dhaillant/REC/hardware/0.1/2024-04-18 14.53.38 det.jpg

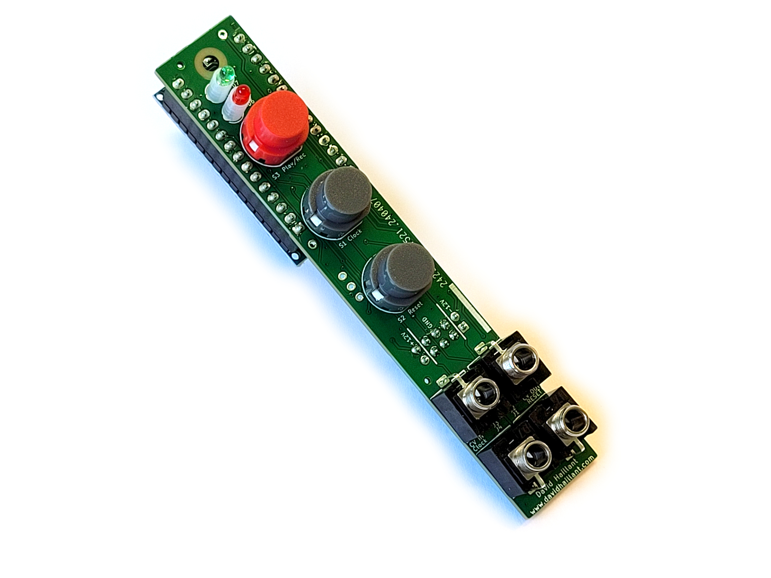
hardware/0.1/2024-04-18 14.53.38 det.jpg
