dhaillant/REC/hardware/0.1/2024-04-18 14.52.39 det.jpg

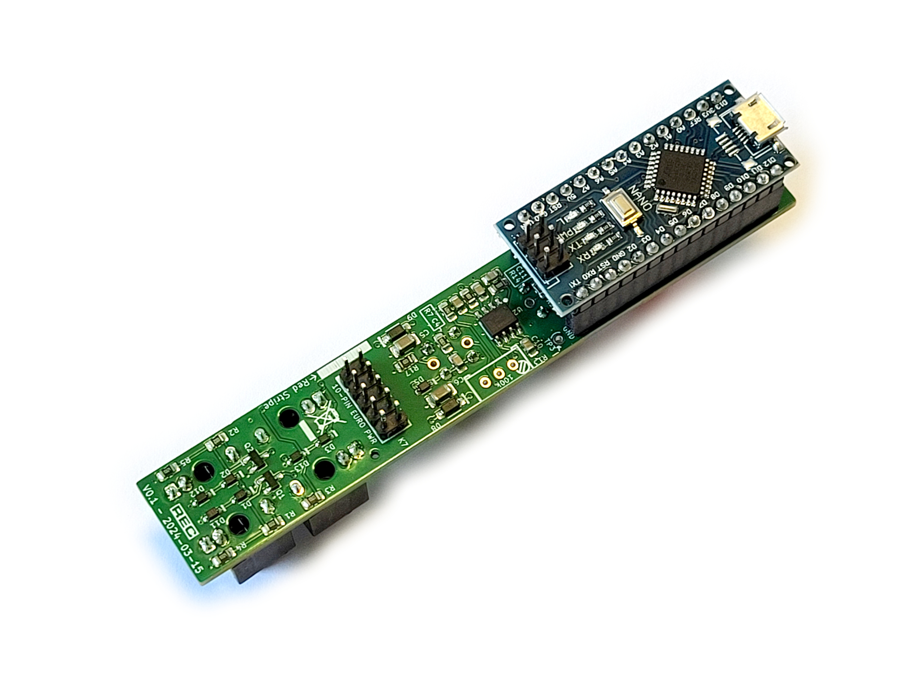
hardware/0.1/2024-04-18 14.52.39 det.jpg
