dhaillant/REC/hardware/0.1/rec-Dual PWM Output.png

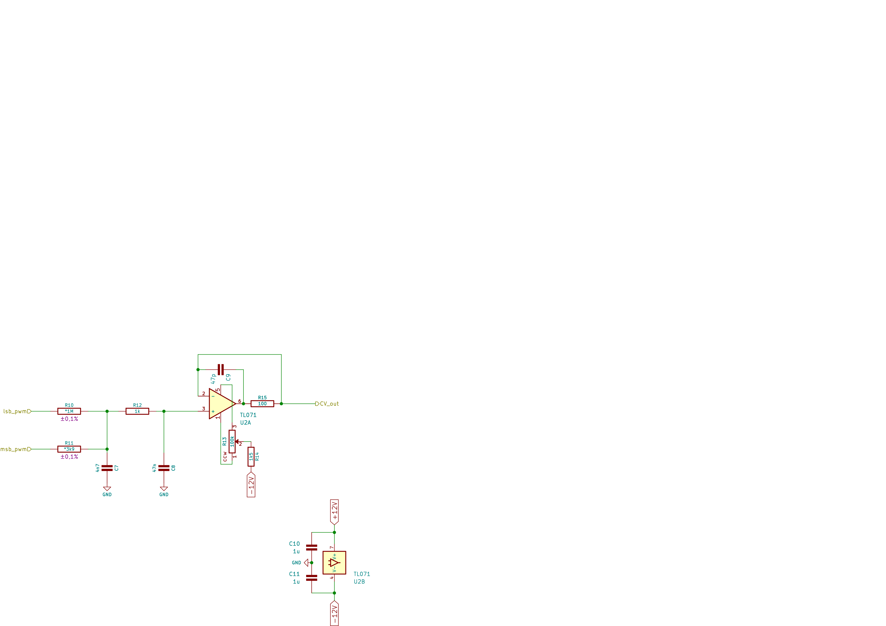
hardware/0.1/rec-Dual PWM Output.png
