dhaillant/REC/hardware/0.1/rec-Inputs.png

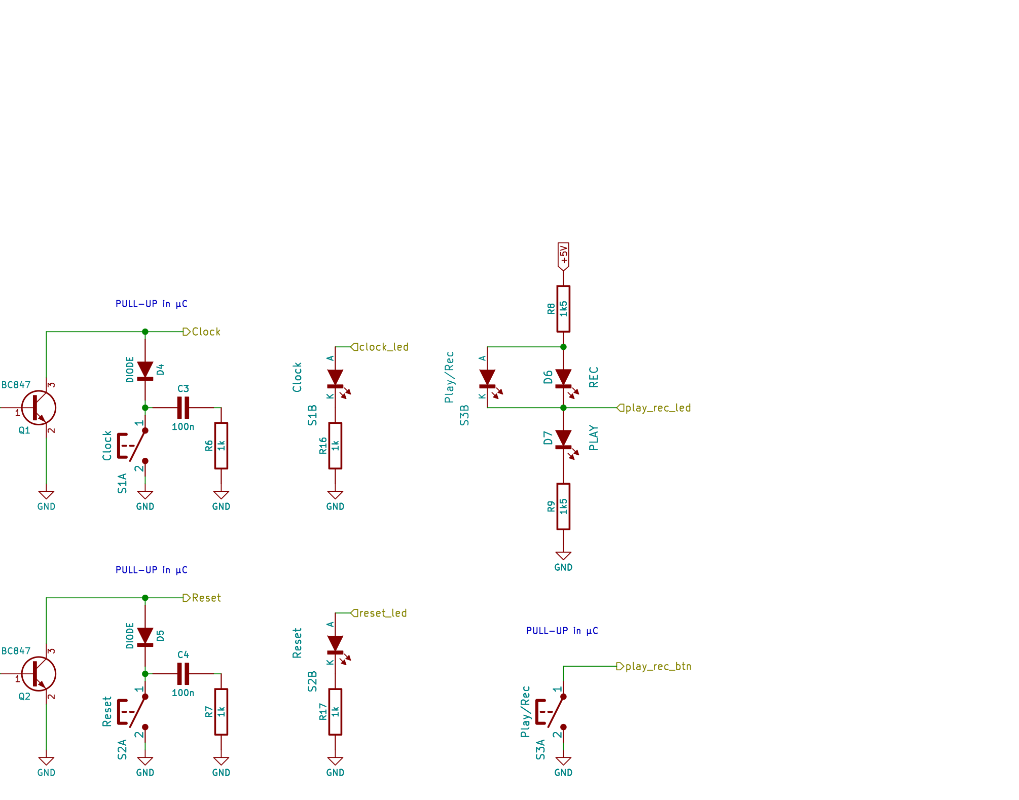
hardware/0.1/rec-Inputs.png
