dhaillant/REC/hardware/0.1/rec.png

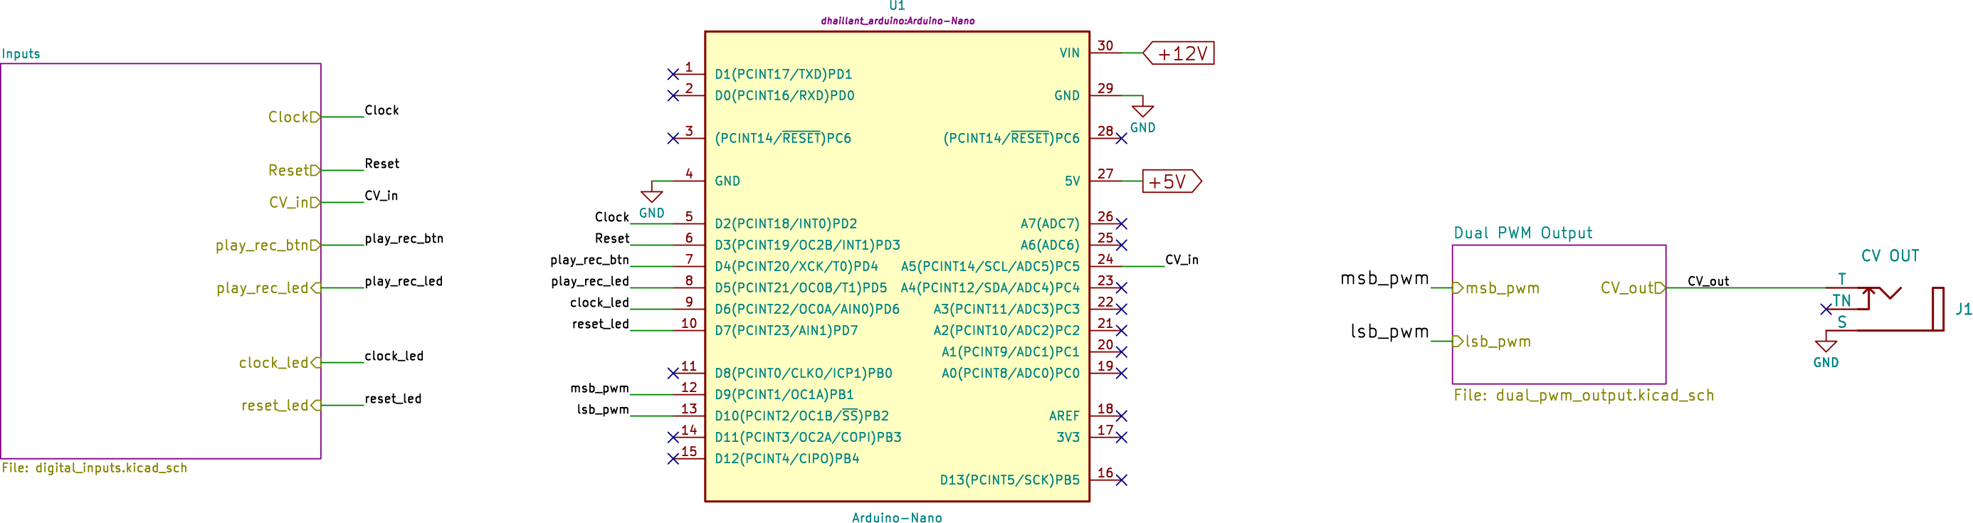
hardware/0.1/rec.png
