dhaillant/REC/(commit log)

2024-04-18 V0.1 schematics
2024-04-18 pictures of prototype V0.1
2024-06-11 new sketch for calibration of PWM output
